abxnx/flight-com-by-film/Missnc/F930J107MAA/3D/F930J107MAA.stp

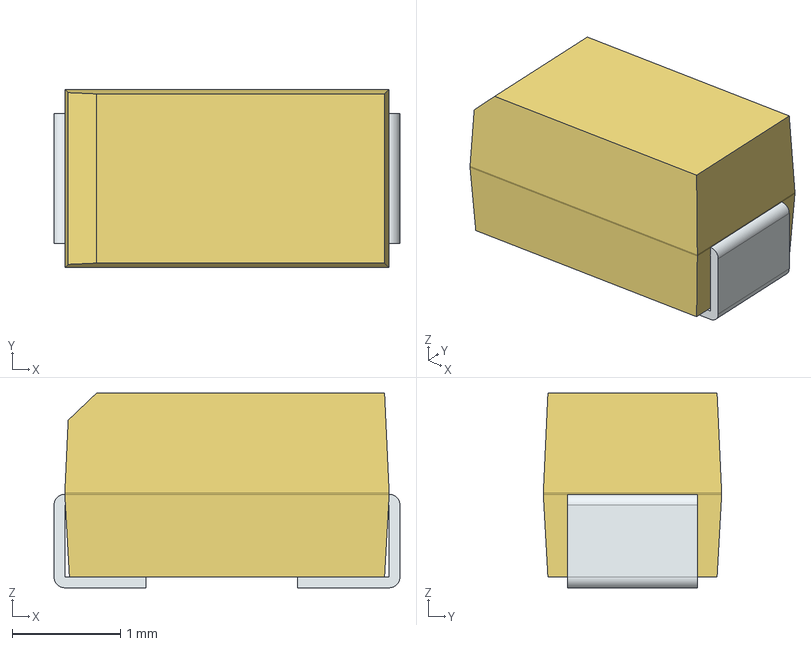
[picture p1: CAD file, 2025-12-26]
Missnc/F930J107MAA/3D/F930J107MAA.stp
3.20 x 1.65 x 1.80 mm
FilletPin1
FilletPin2
