abxnx/flight-com-by-film/Missnc/MEM2080-00-128-00-A/3D/MEM2080-00-128-00-A.stp

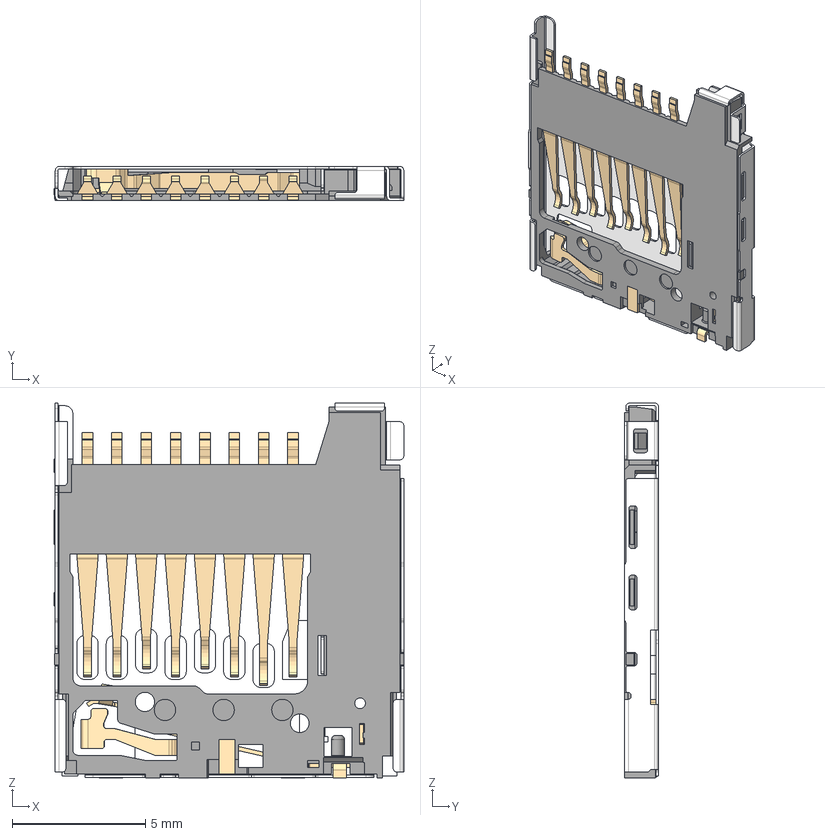
[picture p2: CAD file, 2025-12-26]
Missnc/MEM2080-00-128-00-A/3D/MEM2080-00-128-00-A.stp
13.1 x 1.28 x 14.1 mm
MEM2080-00-128-00-A_PART5
MEM2080-00-128-00-A_PART4
MEM2080-00-128-00-A_PART3
MEM2080-00-128-00-A_PART2
MEM2080-00-128-00-A_PART1
