abxnx/flight-com-by-film/Missnc/SAM_M10Q_00B/SAM-M10Q-00B.step

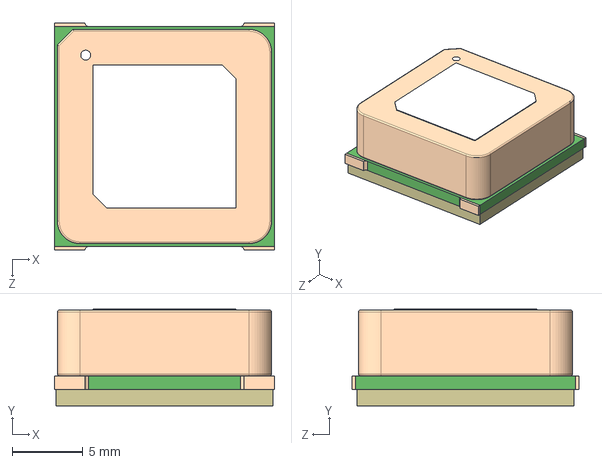
[picture p3: CAD file, 2025-12-26]
Missnc/SAM_M10Q_00B/SAM-M10Q-00B.step
15.5 x 6.80 x 16.0 mm
