abxnx/flight-com-by-film/Missnc/SMA_CONNECTOR/SMA_CONNECTOR.step

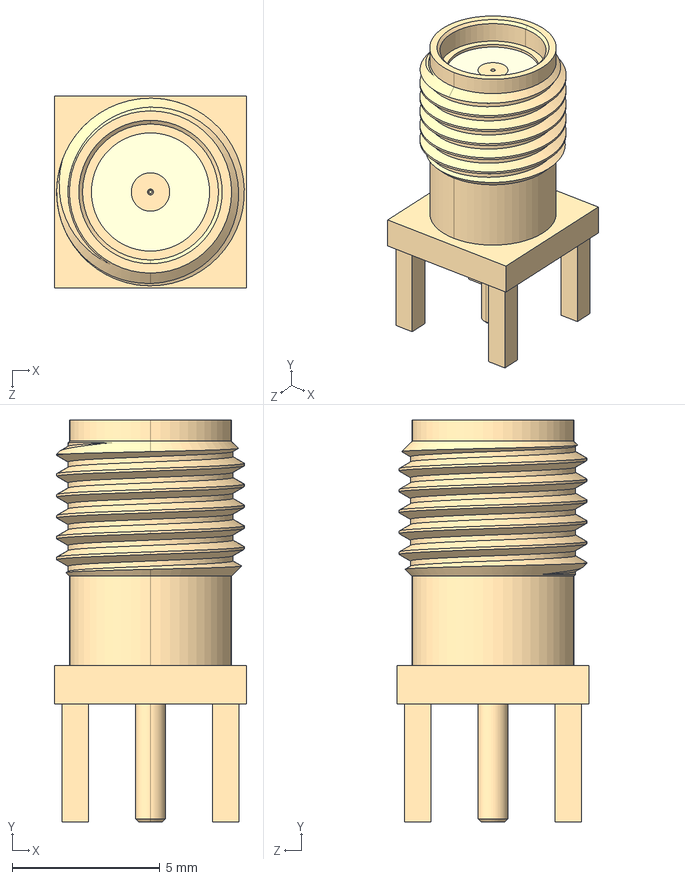
[picture p4: CAD file, 2025-12-26]
Missnc/SMA_CONNECTOR/SMA_CONNECTOR.step
6.50 x 13.6 x 6.50 mm
