abxnx/flight-com-by-film/Missnc/SN74HCT125DRG4/3D/SN74HCT125DRG4.stp

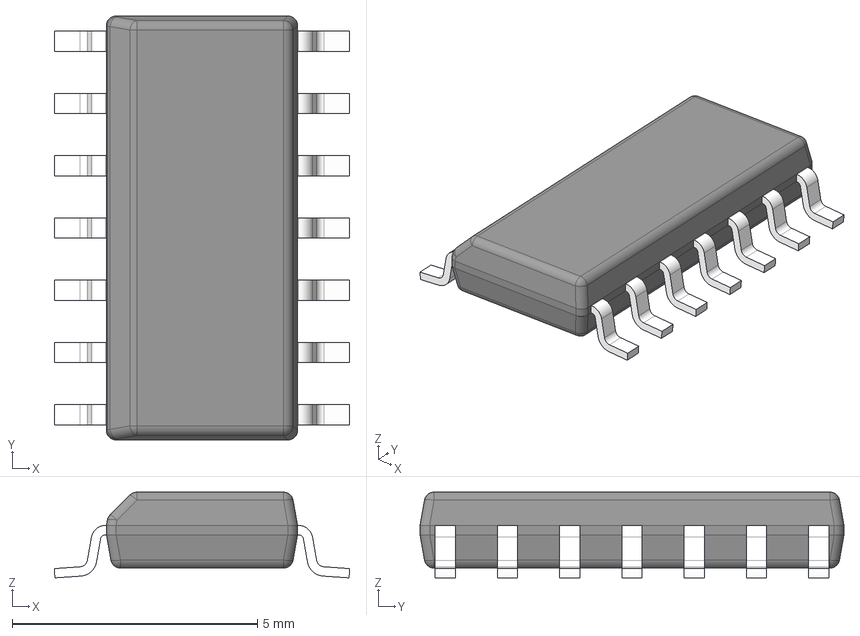
[picture p5: CAD file, 2025-12-26]
Missnc/SN74HCT125DRG4/3D/SN74HCT125DRG4.stp
6.03 x 8.65 x 1.75 mm
BODY-SO
LEAD-SO x 14
PIN1-ID
