abxnx/flight-com-by-film/sensor/MS560702BA03-50/KiCad/MMC5983MA_MEM.step

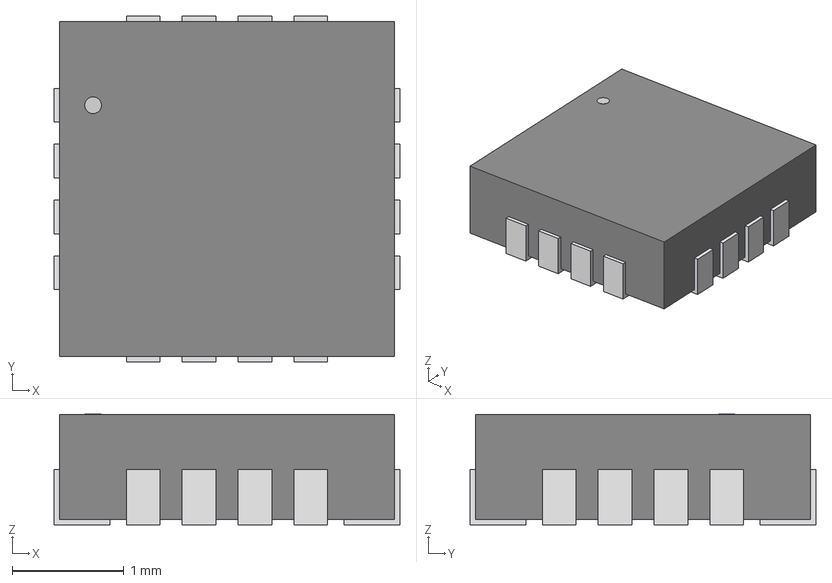
[picture p6: CAD file, 2025-12-26]
sensor/MS560702BA03-50/KiCad/MMC5983MA_MEM.step
3.10 x 3.10 x 0.993 mm
