abxnx/flight-com-by-film/sensor/TMP275AIDGKR/TMP275AIDGKR.step

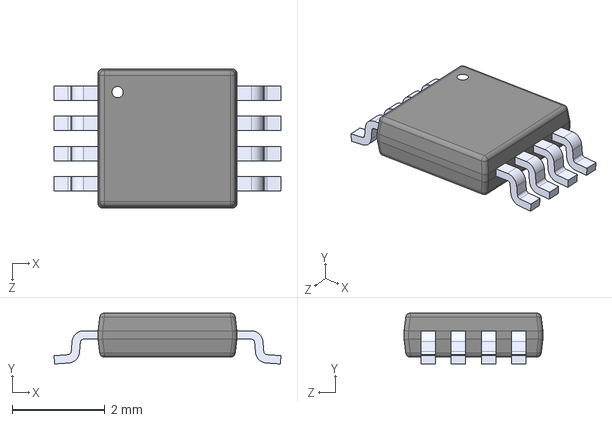
[picture p7: CAD file, 2025-12-26]
sensor/TMP275AIDGKR/TMP275AIDGKR.step
4.90 x 1.10 x 3.00 mm
