abxnx/flight-com-by-film/Missnc/TPS62153RGTR/3D/TPS62153RGTR.stp

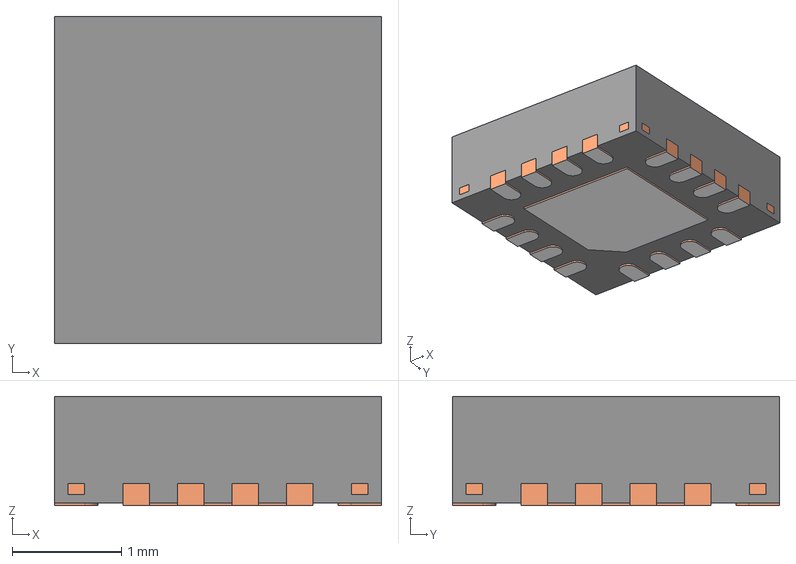
[picture p8: CAD file, 2025-12-26]
Missnc/TPS62153RGTR/3D/TPS62153RGTR.stp
3.00 x 3.00 x 1.00 mm
BODY-QFN
FRAME-RGT0016C
PIN1-ID
