abxnx/flight-com-by-film/sensor/MS560702BA03-50/3D/MS560702BA03-50.stp

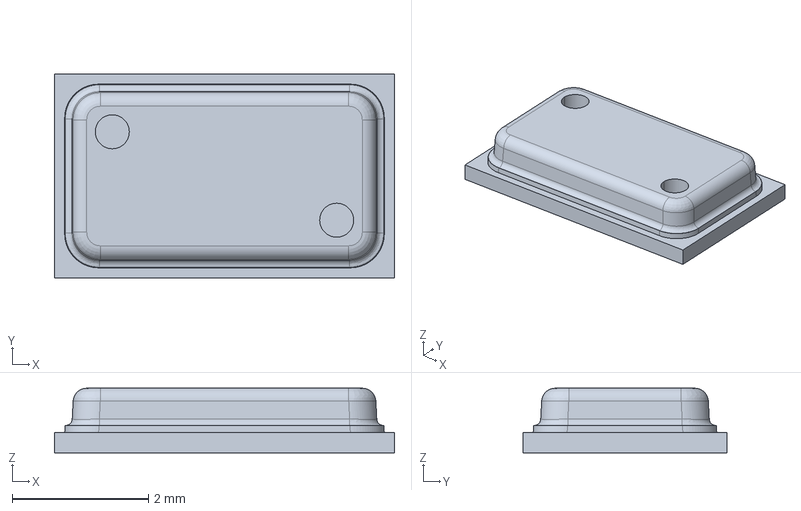
[picture p9: CAD file, 2025-12-26]
sensor/MS560702BA03-50/3D/MS560702BA03-50.stp
5.00 x 3.00 x 0.95 mm
