abxnx/flight-com-by-film/(list of files, cad)

Other CAD files:
Missnc/F930J107MAA/Allegro/cappm3216x180n.psm
Missnc/F930J107MAA/DEHDL/f930j107maa/chips/chips.prt
Missnc/MEM2080-00-128-00-A/Allegro/mem20800012800a.psm
Missnc/MEM2080-00-128-00-A/DEHDL/mem2080_00_128_00_a/chips/chips.prt
Missnc/SN74HCT125DRG4/Allegro/soic127p600x175-14n.psm
Missnc/SN74HCT125DRG4/DEHDL/sn74hct125drg4/chips/chips.prt
Missnc/TPS62153RGTR/Allegro/qfn50p300x300x100-17n-d.psm
Missnc/TPS62153RGTR/DEHDL/tps62153rgtr/chips/chips.prt
sensor/MS560702BA03-50/Allegro/ms5607-02ba03.psm
sensor/MS560702BA03-50/DEHDL/ms560702ba03_50/chips/chips.prt
