abxnx/flight-com-by-film/(list of files, drawings)

Other design files:
Missnc/F930J107MAA/Altium/CAPPM3216X180N.PcbLib
Missnc/F930J107MAA/Altium/F930J107MAA.SchLib
Missnc/MEM2080-00-128-00-A/Altium/MEM2080-00-128-00-A.SchLib
Missnc/MEM2080-00-128-00-A/Altium/MEM20800012800A.PcbLib
Missnc/SN74HCT125DRG4/Altium/SN74HCT125DRG4.SchLib
Missnc/SN74HCT125DRG4/Altium/SOIC127P600X175-14N.PcbLib
Missnc/TPS62153RGTR/Altium/QFN50P300X300X100-17N-D.PcbLib
Missnc/TPS62153RGTR/Altium/TPS62153RGTR.SchLib
