abxnx/flight-com-by-film/Flight_com v.2.kicad_pcb

## KiCad design Flight_com v.2.kicad_pcb (2025-12-26)

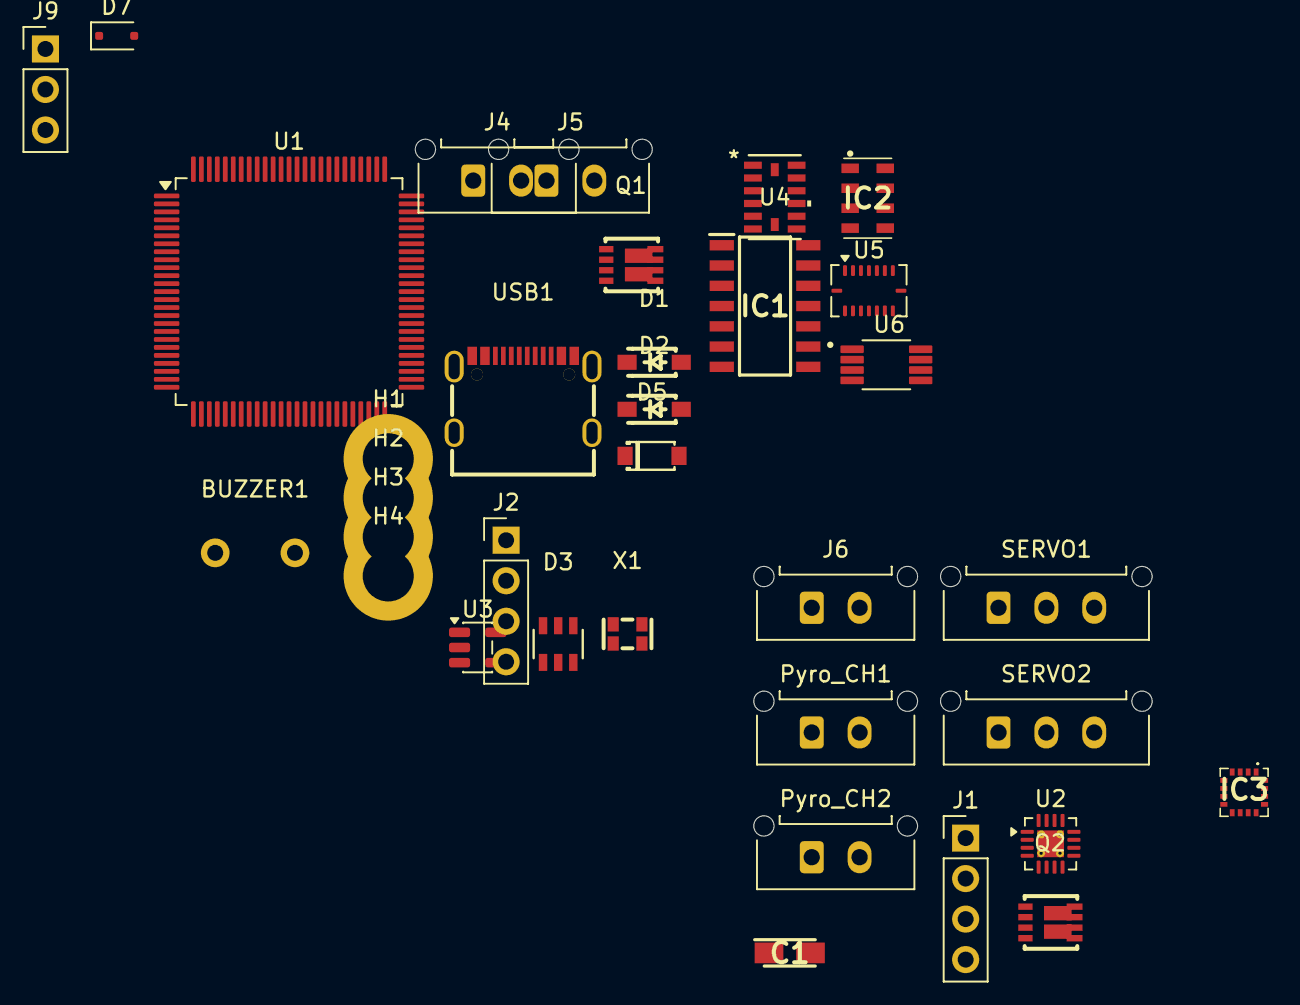
[picture p10: board Flight_com v.2.kicad_pcb from above]

Board: 2 copper layers, 34 parts (0 on the bottom side), 40 nets, no tracks yet.

Parts:
BUZZER1: PS1240P02BT; BUZ-TH_BD12.5-P5.00-D0.9
C1: F930J107MAA; CAPPM3216X180N
D1, D2: NRVB120VLSFT1G; SOD-123_L2.7-W1.6-LS3.7-RD-1
D3: USBLC6-2SC6; SOT-23-6_L2.9-W1.6-P0.95-LS2.8-BL
D5: MMSZ4683T1G; SOD-123_L2.8-W1.8-LS3.7-RD
D7: PMEG2005EJ; D_SOD-323F
H1, H2, H3, H4: MountingHole_Pad; MountingHole_3.2mm_M3_DIN965_Pad
IC1: SN74HCT125DRG4; SOIC127P600X175-14N
IC2: MS560702BA03-50; MS5607-02BA03
IC3: MMC5983MA
J1: Companion; PinHeader_1x04_P2.54mm_Vertical
J2: SWD; PinHeader_1x04_P2.54mm_Vertical
J4, J5, J6: Molex Microfit; Molex_Micro-Fit_3.0_43650-0215_1x02_P3.00mm_Vertical
J9: Conn_01x03_Pin; PinHeader_1x03_P2.54mm_Vertical
Pyro_CH1, Pyro_CH2: Molex Microfit; Molex_Micro-Fit_3.0_43650-0215_1x02_P3.00mm_Vertical
Q1, Q2: SI7232DN-T1-GE3; POWER-1212-8_L3.3-W3.3-P0.66-LS3.3-BL
SERVO1, SERVO2: Conn_01x03_Pin; Molex_Micro-Fit_3.0_43650-0315_1x03_P3.00mm_Vertical
U1: STM32U575VGTx; LQFP-100_14x14mm_P0.5mm
U2: TPS62153; VQFN-16-1EP_3x3mm_P0.5mm_EP1.68x1.68mm_ThermalVias
U3: TLV75733PDBV; SOT-23-5
U4: ADXL375BCCZ-RL7; LGA_CC-14-1_ADI
U5: BMI088; Bosch_LGA-16_4.5x3mm_P0.5mm_LayoutBorder7x1y_ClockwisePinNu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
U6: TMP275AIDGKR; SOP65P490X110-8N
USB1: TYPE-C-2.0-16PIN-SMT-3; TYPE-C-SMD_TYPE-CF3.1
X1: 1XXD32000MBA; OSC-SMD_4P-L2.0-W1.6-BL_1XXD

Connections:
+3.3V: D7.2 (A), IC2.1 (VDD), IC3.2 (VDD), IC3.4 (SPI_CS), IC3.13 (VDDIO), J1.1, J2.1, U3.5 (OUT), U4.1 (VDDI/O), U4.6 (VS), U5.3 (VDD), U5.11 (VDDIO), U6.8 (V+), X1.4 (VCC)
+5V: C1.1 (+), D2.2 (A), IC1.14 (VCC), J4.2, U2.14 (VOS)
/PWM_PD: IC1.1 (1~OE), IC1.4 (2~OE), IC1.10 (3~OE), IC1.13 (4~OE)
ADXL_CS: U1.68 (PA9), U4.7 (*CS)
ADXL_INT1: U1.83 (PD2), U4.8 (INT1)
ADXL_INT2: U1.84 (PD3), U4.9 (INT2)
ADXL_MISO: U1.79 (PC11), U1.80 (PC12), U4.13 (SDA/SDI/SDIO)
ADXL_SCLK: IC2.8 (SCLK), U1.78 (PC10), U4.14 (SCL/SCLK)
BMI_Accel_CS: U1.55 (PD8), U5.14 (~CSB1)
BMI_Accel_INT1: U1.64 (PC7), U5.16 (INT1)
BMI_Accel_INT2: U1.65 (PC8), U5.1 (INT2)
BMI_GYRO_CS: U1.56 (PD9), U5.5 (~CSB2)
BMI_Gyro_INT1: U1.81 (PD0), U5.12 (INT3)
BMI_Gyro_INT2: U1.82 (PD1), U5.13 (INT4)
BMI_MISO: U1.53 (PB14), U5.10 (SDO2), U5.15 (SDO1)
BMI_MOSI: U1.54 (PB15), U5.9 (SDI/SDA)
BMI_SCK: U1.52 (PB13), U5.8 (SCK/SCL)
D+: D3.1, USB1.A6 (DP1), USB1.B6 (DP2)
D-: D3.3, USB1.A7 (DN1), USB1.B7 (DN2)
MMC_INT: IC3.15 (INT), U1.91 (PB5)
MMC_SCK: IC3.1 (SCL/SPI_SCK), U1.92 (PB6)
MMC_SDA: IC3.16 (SDA/SPI_SDI), U1.93 (PB7)
MS_CS: IC2.5 (CSB_2), U1.67 (PA8)
unnamed: BUZZER1.1, Q2.5 (D2), Q2.6 (D2)
unnamed: U2.1 (SW), U2.2 (SW), U2.3 (SW)
unnamed: Pyro_CH1.2, Q1.7 (D1), Q1.8 (D1)
unnamed: Pyro_CH2.2, Q1.5 (D2), Q1.6 (D2)
unnamed: U1.10 (VSS), U1.27 (VSS), U1.49 (VSS), U1.74 (VSS), U1.99 (VSS)
PWM_D: IC1.9 (3A), IC1.12 (4A)
PYRO: J5.2, Pyro_CH1.1, Pyro_CH2.1
PYRO_A: IC1.3 (1Y), Q1.2 (G1)
PYRO_B: C1.2 (-), D3.2, D5.2 (A), H1.1, H2.1, H3.1, H4.1, IC1.6 (2Y), IC1.7 (GND), IC2.2 (PS), IC2.3 (GND), IC3.9 (GND_1), IC3.11 (GND_2), J1.4, J2.4, J4.1, J5.1, J6.1, J9.3, Q1.1 (S1), Q1.3 (S2), Q1.4 (G2), Q2.3 (S2), SERVO1.3, SERVO2.3, U2.5 (FB), U2.6 (GND), U2.7 (FSW), U2.8 (DEF), U2.15 (GND), U2.16 (GND), U2.17 (GND), U3.2 (GND), U4.2 (GND), U4.4 (GND), U4.5 (GND), U5.2 (GNDA), U5.4 (GNDA), U5.6 (GNDIO), U5.7 (PS), U6.4 (GND), U6.5 (A2), U6.6 (A1), U6.7 (A0), USB1.1 (EH), USB1.A1 (GND), USB1.A12 (GND), USB1.B1 (GND), USB1.B12 (GND), X1.1 (GND), X1.2 (GND)
SERVO_B: IC1.8 (3Y), IC1.11 (4Y), SERVO2.1
ServoPow: J6.2, SERVO1.2, SERVO2.2
TMP_ALERT: U1.58 (PD11), U6.3 (ALERT)
TMP_SCL: U1.59 (PD12), U6.2 (SCL)
TMP_SDA: U1.60 (PD13), U6.1 (SDA)
VBAT+: U2.10 (VIN), U2.11 (VIN), U2.12 (VIN), U2.13 (EN)
VBUS: D1.2 (A), D3.5, USB1.A4 (VBUS), USB1.A9 (VBUS), USB1.B4 (VBUS), USB1.B9 (VBUS)
VBUSout: D1.1 (K), D2.1 (K), U3.1 (IN), U3.3 (EN)
