abxnx/flight-com-by-film/Flight_com v.2.ioc

Mcu.UserName=STM32U575VGTx
PA4.Signal=SPI1_NSS
PA5.Signal=SPI1_SCK
PA6.Signal=SPI1_MISO
PA7.Signal=SPI1_MOSI
