abxnx/flight-com-by-film/(commit log)

2025-10-03 set up project
    [Fligt_com v.1.kicad_pcb, Fligt_com v.1.kicad_sch]
2025-10-09 Update avionics PCB schematic
    [Fligt_com v.1.kicad_pcb]
2025-12-26 Resolve merge conflict: ignore fp-info-cache
    [CAPPM3216X180N.PcbLib, EDI2CAP.CFG, F930J107MAA.SchLib, F930J107MAA.stp, Flight_com v.2.kicad_pcb, Flight_com v.2.kicad_sch, MEM2080-00-128-00-A.SchLib, MEM2080-00-128-00-A.stp]
2025-12-26 Remove KiCad v1 files from repo
    [Fligt_com v.1.kicad_pcb, Fligt_com v.1.kicad_sch]
