abxnx/flight-com-by-film/(notices)

Notices in the files:
Missnc/MEM2080-00-128-00-A/3D/MEM2080-00-128-00-A.stp:
author */ ('License CC BY-ND 4.0'),
